jekhor/cave-phone-mc34118/cave-phone-mc34118.kicad_pcb

## KiCad design cave-phone-mc34118.kicad_pcb (2022-04-27)

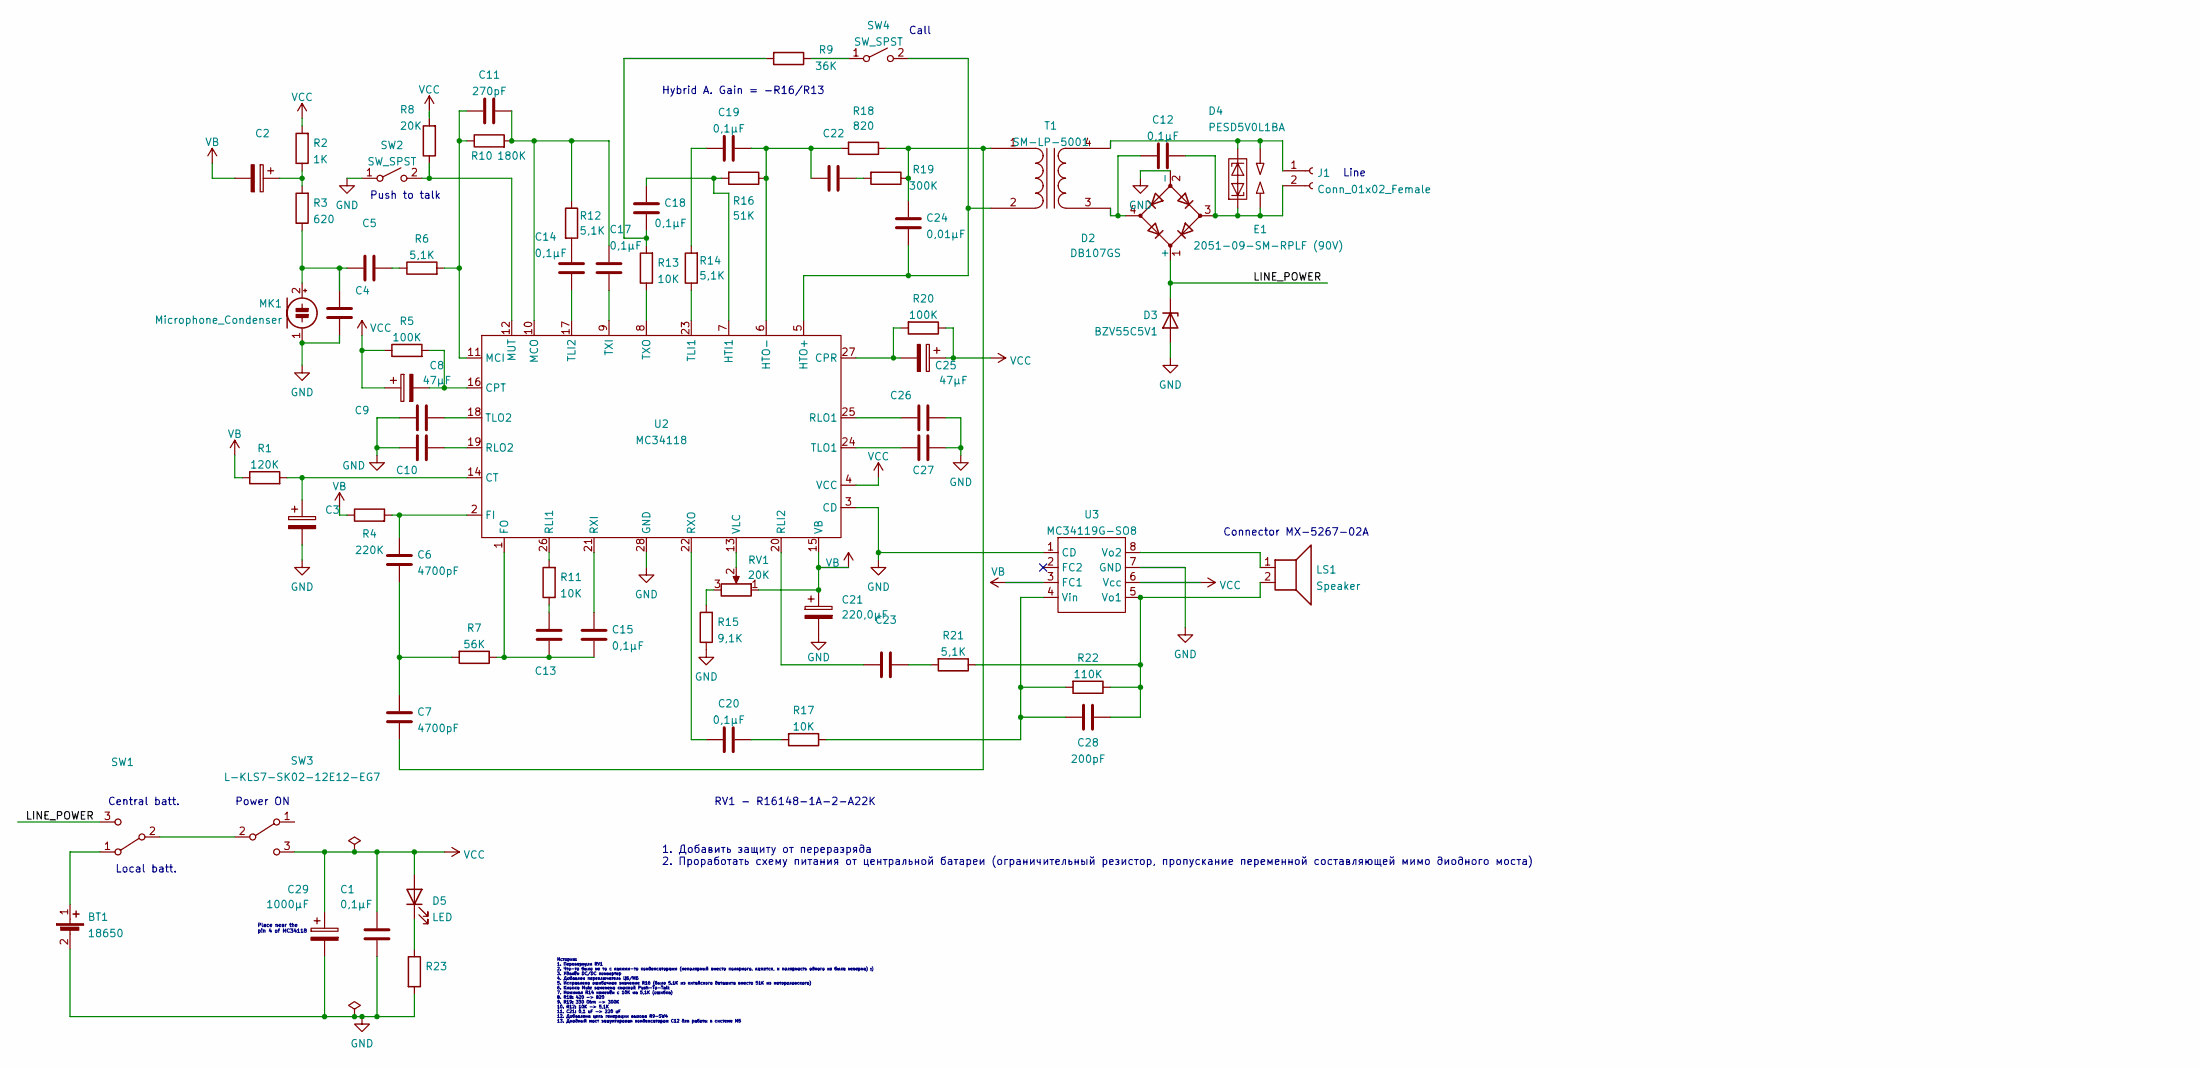
[picture p1: schematic cave-phone-mc34118.kicad_sch]

Parts:
BT1: 18650; BatteryHolder_MPD_BH-18650-PC2
C1, C12, C14, C15, C17, C18, C19, C20: 0,1µF; C_0805_2012Metric_Pad1.18x1.45mm_HandSolder
C2, C3: (no value)
C4, C5, C9, C10, C13, C22, C23, C26, C27: C_0805_2012Metric_Pad1.18x1.45mm_HandSolder
C6, C7: 4700pF; C_0805_2012Metric_Pad1.18x1.45mm_HandSolder
C8: 47µF; CP_EIA-3528-21_Kemet-B_Pad1.50x2.35mm_HandSolder
C11: 270pF; C_0805_2012Metric_Pad1.18x1.45mm_HandSolder
C21: 220,0µF
C24: 0,01µF; C_0805_2012Metric_Pad1.18x1.45mm_HandSolder
C25: 47µF
C28: 200pF; C_0805_2012Metric_Pad1.18x1.45mm_HandSolder
C29: 1000µF
D2: DB107GS; Diode_Bridge_Vishay_DFS
D3: BZV55C5V1; D_MiniMELF
D4: PESD5V0L1BA; D_SOD-323
D5: LED; LED_D3.0mm
E1: 2051-09-SM-RPLF (90V); Fuse_1812_4532Metric
J1: Conn_01x02_Female
LS1: Speaker; Molex_SPOX_5267-02A_1x02_P2.50mm_Vertical
MK1: Microphone_Condenser; MIC_CMA-4544PF-W
R1: 120K
R2: 1K
R3: 620
R4: 220K
R5, R20: 100K
R6, R12, R14, R21: 5,1K
R7: 56K
R8: 20K
R9: 36K
R10: 180K
R11, R13, R17: 10K
R15: 9,1K
R16: 51K
R18: 820
R19: 300K
R22: 110K
R23: (no value)
RV1: 20K; Potentiometer_Alps_RK163_Single_Horizontal
SW1: KLS7-SK02-12E12
SW2, SW4: SW_SPST
SW3: L-KLS7-SK02-12E12-EG7; KLS7-SK02-12E12
T1: SM-LP-5001
U2: MC34118; SOIC-28W_7.5x17.9mm_P1.27mm
U3: MC34119G-SO8; SOP-8_3.9x4.9mm_P1.27mm

Connections:
/LINE_POWER: D2.1 (+), D3.1 (K), SW1.3 (C)
GND: BT1.2 (-), C1.2, C3.2, C4.1, C9.1, C10.1, C21.2, C26.1, C27.1, C29.2, D2.2 (-), D3.2 (A), MK1.1 (-), R15.1, R23.2, SW2.1 (A), U2.3 (CD), U2.28 (GND), U3.1 (CD), U3.7 (GND)
unnamed: BT1.1 (+), SW1.1 (A)
unnamed: C2.1, R2.1, R3.2
unnamed: C3.1, R1.2, U2.14 (CT)
unnamed: C4.2, C5.1, MK1.2 (+), R3.1
unnamed: C5.2, R6.1
unnamed: C6.1, C7.2, R7.2
unnamed: C6.2, R4.2, U2.2 (FI)
unnamed: C8.2, R5.2, U2.16 (CPT)
unnamed: C9.2, U2.18 (TLO2)
unnamed: C10.2, U2.19 (RLO2)
unnamed: C11.1, C17.2, R10.2, R12.1, U2.10 (MCO)
unnamed: C11.2, R6.2, R10.1, U2.11 (MCI)
unnamed: C12.1, D2.3, D4.1 (K1), E1.1, J1.2
unnamed: C12.2, D2.4, T1.3 (SA)
unnamed: C13.1, C15.1, R7.1, U2.1 (FO)
unnamed: C13.2, R11.1
unnamed: C14.1, U2.17 (TLI2)
unnamed: C14.2, R12.2
unnamed: C15.2, U2.21 (RXI)
unnamed: C17.1, U2.9 (TXI)
unnamed: C18.1, R9.2, R13.2
unnamed: C18.2, R16.2, U2.7 (HTI1)
unnamed: C19.1, C22.2, R16.1, R18.2, U2.6 (HTO-)
unnamed: C19.2, R14.2
unnamed: C20.1, R17.2
unnamed: C20.2, U2.22 (RXO)
unnamed: C22.1, R19.2
unnamed: C23.1, R21.2
unnamed: C23.2, U2.20 (RLI2)
unnamed: C7.1, C24.1, R18.1, R19.1, T1.1 (AA)
unnamed: C24.2, SW4.2 (B), T1.2 (AB), U2.5 (HTO+)
unnamed: C25.2, R20.2, U2.27 (CPR)
unnamed: C26.2, U2.25 (RLO1)
unnamed: C27.2, U2.24 (TLO1)
unnamed: C28.1, LS1.2, R21.1, R22.1, U3.5 (Vo1)
unnamed: C28.2, R17.1, R22.2, U3.4 (Vin)
unnamed: D4.2 (A), E1.2, J1.1, T1.4 (SB)
unnamed: D5.1 (K), R23.1
unnamed: LS1.1, U3.8 (Vo2)
unnamed: R8.1, SW2.2 (B), U2.12 (MUT)
unnamed: R9.1, SW4.1 (A)
unnamed: R11.2, U2.26 (RLI1)
unnamed: R13.1, U2.8 (TXO)
unnamed: R14.1, U2.23 (TLI1)
unnamed: R15.2, RV1.3
unnamed: RV1.2, U2.13 (VLC)
unnamed: SW1.2 (B), SW3.2 (B)
VB: C2.2, C21.1, R1.1, R4.1, RV1.1, U2.15 (VB), U3.3 (FC1)
VCC: C1.1, C8.1, C25.1, C29.1, D5.2 (A), R2.2, R5.1, R8.2, R20.1, SW3.3 (C), U2.4 (VCC), U3.6 (Vcc)

Notes on the sheet:
Connector MX-5267-02A
Central batt.
1. Добавить защиту от переразряда 2. Проработать схему питания от центральной батареи (ограничительный резистор, пропускание переменной составляющей мимо диодного моста)
Hybrid A. Gain = -R16/R13
Call
Push to talk
Place near the pin 4 of MC34118
Power ON
История: 1. Перевернули RV1 2. Что-то было не то с какими-то конденсаторами (неполярный вместо полярного, кажется, и полярность одного из была неверна) :) 3. Удалён DC/DC конвертер 4. Добавлен переключатель ЦБ/МБ 5. Исправлено ошибочное значение R16 (было 5.1К из китайского даташита вместо 51К из м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
RV1 - R16148-1A-2-A22K
Line
Local batt.

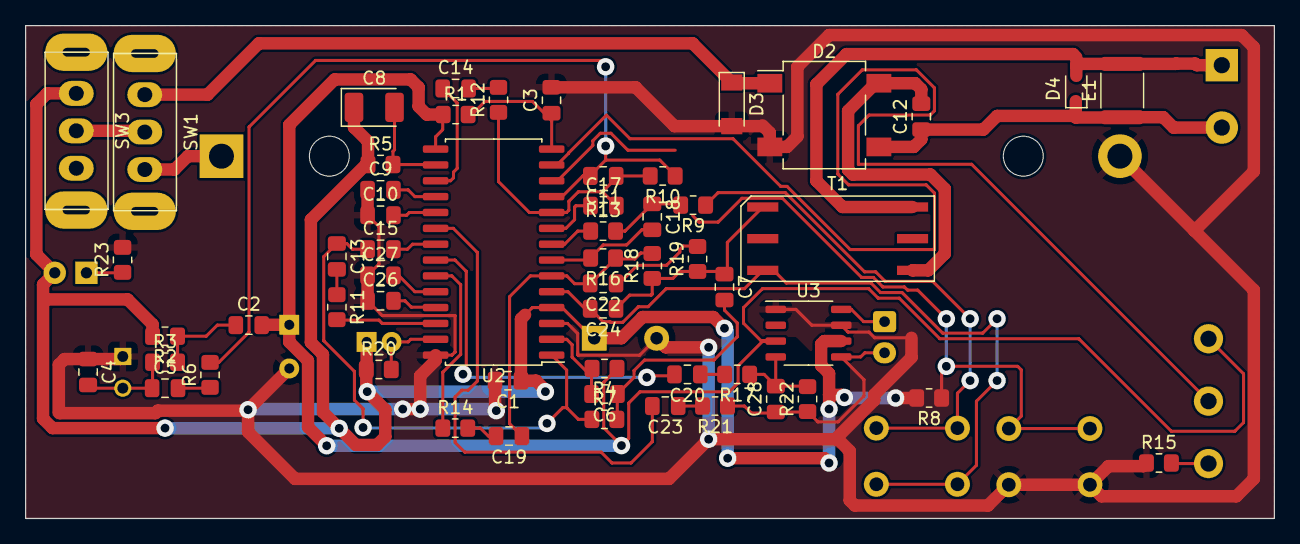
[picture p2: board cave-phone-mc34118.kicad_pcb from above]

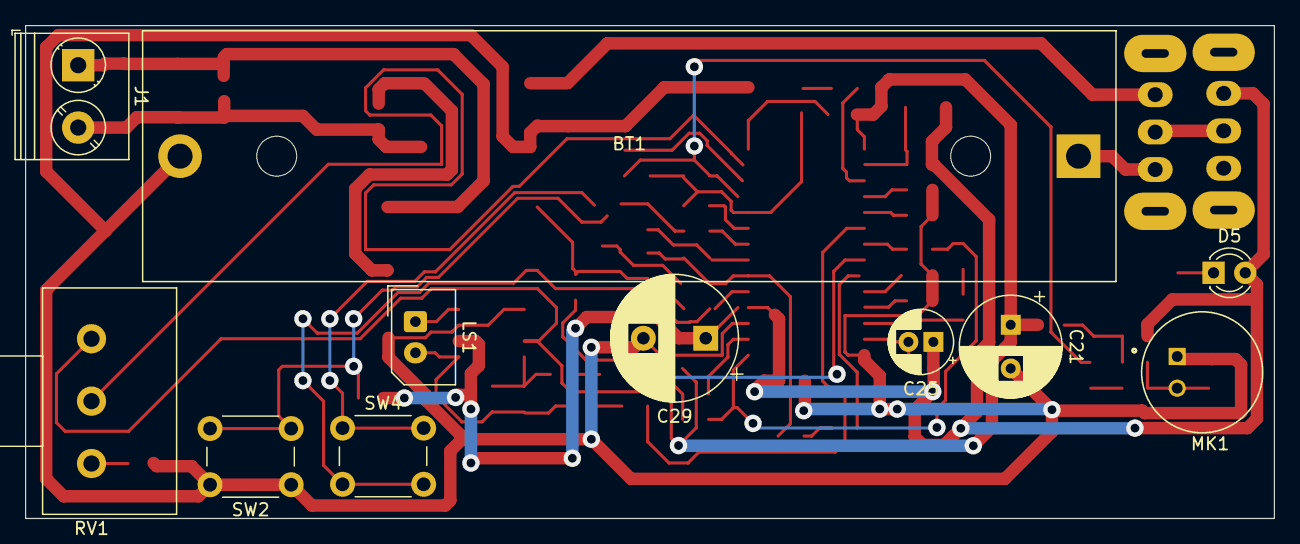
[picture p3: board cave-phone-mc34118.kicad_pcb from below]

Board: 2 copper layers, 100.1 x 39.5 mm, 68 parts (11 on the bottom side), 51 nets.
