jekhor/cave-phone-mc34118/(commit log)

2022-02-20 Reference schematics (from the datasheet)
    [cave-phone-mc34118.kicad_sch]
2022-02-26 v0.1 (wrong U2 package)
    [cave-phone-mc34118.kicad_pcb, cave-phone-mc34118.kicad_sch]
2022-02-28 Rework PCB for right MC34118 package
    [cave-phone-mc34118.kicad_pcb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]
2022-03-22 Fix prototype status
    [cave-phone-mc34118.kicad_pcb, cave-phone-mc34118.kicad_sch]
2022-04-25 sch: Remove DC-DC
    [cave-phone-mc34118.kicad_sch]
2022-04-26 Fix some errors and add improvements
    [cave-phone-mc34118.kicad_sch]
2022-04-26 WiP: New PCB (0805 SMDs)
    [cave-phone-mc34118.kicad_pcb, cave-phone-mc34118.kicad_sch]
2022-04-27 WiP: New PCB
    [cave-phone-mc34118.kicad_pcb, cave-phone-mc34118.kicad_sch]
